StathisKEl/autonomous_greenhouse/README.md

# autonomous_greenhouse
An autonomous greenhouse based on the Arduino Mega 2560 Rev3 development board.

The code inside the greenhouse_code.ino file is under the GNU General Public v3.0 license (the SECOND LICENSE.txt file) and the hardware of the autonomous greenhouse is under the CERN Open Hardware Version 2 - Strongly Reciprocal license (the FIRST LICENSE.txt file).
